alheir/gatebench/README.md

# GateBench

Educational FPGA lab board for the UPduino v3.1. Switches, LEDs, 7-segment display, VGA, R-2R DAC, ADC and WS2812 behind shift-register scan chains, with a Verilog BSP and worked examples.
