alheir/gatebench/hardware/3d/README.md

3D STEP models for the GateBench PCB (tracked with Git LFS).
