alheir/gatebench/(list of files, cad)

Other CAD files:
hardware/3d/EC11_Rotary_Encoder_Switched.step
hardware/3d/R-0904N-L-20KQ.step
hardware/3d/UPduino_v3.01.step
hardware/3d/USB_B_OST_USB-B1HSxx_Horizontal.step
