alheir/gatebench/hardware/gatebench.kicad_pcb

## KiCad design hardware/gatebench.kicad_pcb (2026-09-05)

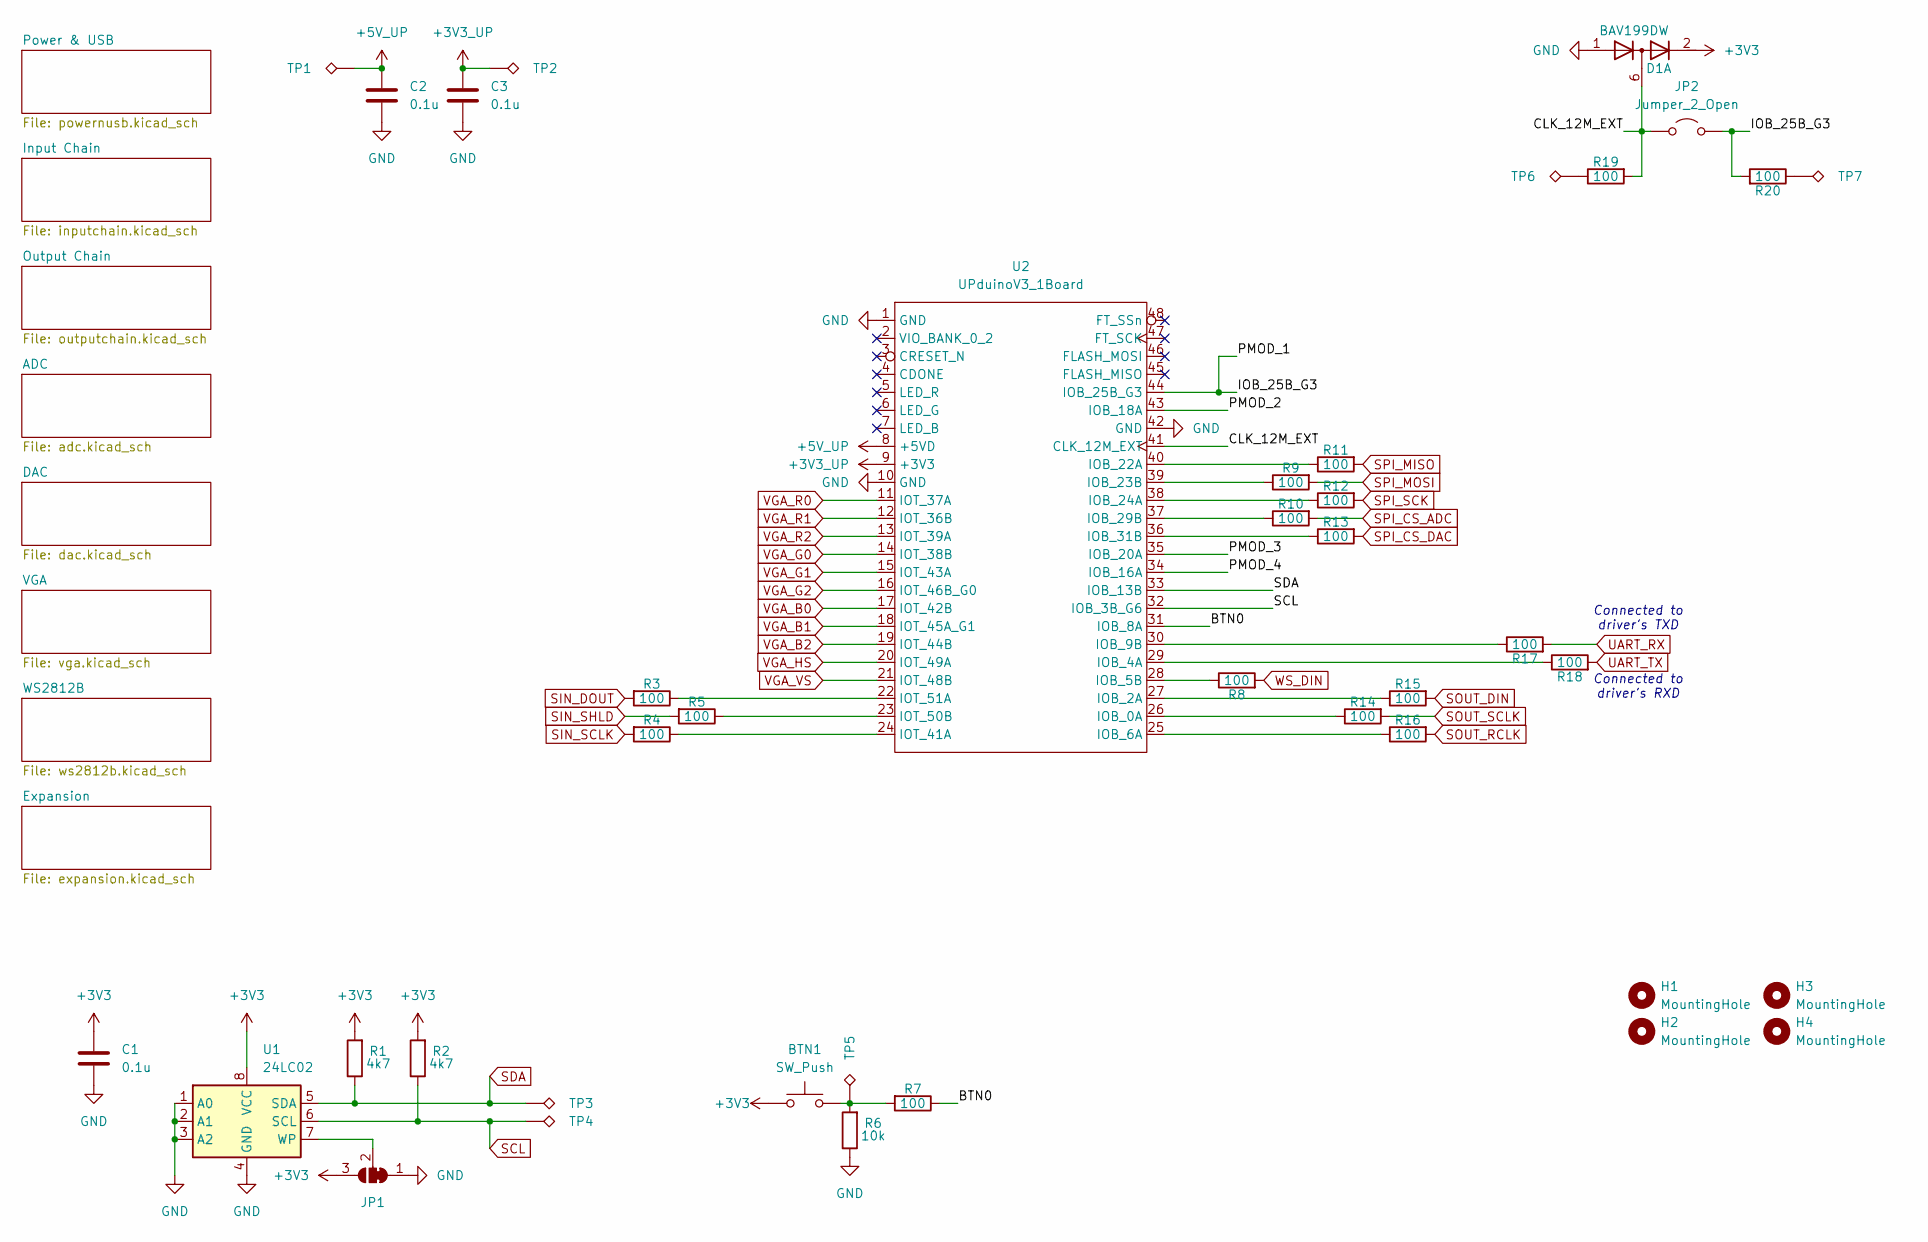
[picture p1: schematic gatebench.kicad_sch]

Parts:
BTN1: SW_Push; SW_PUSH_6mm_H8.5mm; JLCPCB C22397158
C1, C2, C3: 0.1u; C_0603_1608Metric_Pad1.08x0.95mm_HandSolder; JLCPCB C1705
D1: BAV199DW; SOT-363_SC-70-6
H1, H2, H3, H4: MountingHole; MountingHole_3.2mm_M3
JP1: SolderJumper_3_Bridged12; SolderJumper-3_P1.3mm_Bridged2Bar12_RoundedPad1.0x1.5mm_Num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
JP2: Jumper_2_Open
R1, R2: 4k7; R_0603_1608Metric; JLCPCB C22356621
R3, R4, R5, R7, R8, R9, R10, R11, R12, R13, R14, R15, R16, R17, R18, R19, R20: 100; R_0603_1608Metric; JLCPCB C22356621
R6: 10k; R_0603_1608Metric; JLCPCB C22356621
TP1, TP2, TP3, TP4, TP5, TP6, TP7: TestPoint_Alt; PinHeader_1x01_P2.54mm_Vertical
U1: 24LC02; SOIC-8_3.9x4.9mm_P1.27mm
U2: UPduinoV3_1Board; upduino_v3_1

Connections:
+3V3: BTN1.1, C1.1, D1.2 (K2), JP1.3 (B), R1.2, R2.2, U1.8 (VCC); also elsewhere on the board
+3V3_UP: C3.1, TP2.1 (1_1), U2.9 (+3V3); also elsewhere on the board
+5V_UP: C2.1, TP1.1 (1_1), U2.8 (+5VD); also elsewhere on the board
/BTN0: R7.1, U2.31 (IOB_8A)
/CLK_12M_EXT: D1.6 (K3A4), JP2.1 (A), R19.2, U2.41 (CLK_12M_EXT)
/IOB_25B_G3: JP2.2 (B), R20.2, U2.44 (IOB_25B_G3)
/PMOD_2: U2.43 (IOB_18A)
/PMOD_3: U2.35 (IOB_20A)
/PMOD_4: U2.34 (IOB_16A)
GND: C1.2, C2.2, C3.2, D1.1 (A1), JP1.1 (A), R6.1, U1.1 (A0), U1.2 (A1), U1.3 (A2), U1.4 (GND), U2.1 (GND), U2.10 (GND), U2.42 (GND); also elsewhere on the board
unnamed: BTN1.2, R6.2, R7.2, TP5.1 (1_1)
unnamed: JP1.2 (C), U1.7 (WP)
unnamed: R19.1, TP6.1 (1_1)
unnamed: R20.1, TP7.1 (1_1)
unnamed: R14.1, U2.26 (IOB_0A)
unnamed: R15.1, U2.27 (IOB_2A)
unnamed: R18.1, U2.29 (IOB_4A)
unnamed: R8.1, U2.28 (IOB_5B)
unnamed: R16.1, U2.25 (IOB_6A)
unnamed: R17.1, U2.30 (IOB_9B)
unnamed: R11.1, U2.40 (IOB_22A)
unnamed: R9.1, U2.39 (IOB_23B)
unnamed: R12.1, U2.38 (IOB_24A)
unnamed: R10.1, U2.37 (IOB_29B)
unnamed: R13.1, U2.36 (IOB_31B)
unnamed: R4.1, U2.24 (IOT_41A)
unnamed: R5.1, U2.23 (IOT_50B)
unnamed: R3.1, U2.22 (IOT_51A)
PMOD_7: R11.2; also elsewhere on the board
PMOD_8: R9.2; also elsewhere on the board
PMOD_9: R12.2; also elsewhere on the board
SCL: R2.1, TP4.1 (1_1), U1.6 (SCL), U2.32 (IOB_3B_G6); also elsewhere on the board
SDA: R1.1, TP3.1 (1_1), U1.5 (SDA), U2.33 (IOB_13B); also elsewhere on the board
SIN_DOUT: R3.2; also elsewhere on the board
SIN_SCLK: R4.2; also elsewhere on the board
SIN_SHLD: R5.2; also elsewhere on the board
SOUT_DIN: R15.2; also elsewhere on the board
SOUT_RCLK: R16.2; also elsewhere on the board
SOUT_SCLK: R14.2; also elsewhere on the board
SPI_CS_ADC: R10.2; also elsewhere on the board
SPI_CS_DAC: R13.2; also elsewhere on the board
UART_RX: R17.2; also elsewhere on the board
UART_TX: R18.2; also elsewhere on the board
VGA_B0: U2.17 (IOT_42B); also elsewhere on the board
VGA_B1: U2.18 (IOT_45A_G1); also elsewhere on the board
VGA_B2: U2.19 (IOT_44B); also elsewhere on the board
VGA_G0: U2.14 (IOT_38B); also elsewhere on the board
VGA_G1: U2.15 (IOT_43A); also elsewhere on the board
VGA_G2: U2.16 (IOT_46B_G0); also elsewhere on the board
VGA_HS: U2.20 (IOT_49A); also elsewhere on the board
VGA_R0: U2.11 (IOT_37A); also elsewhere on the board
VGA_R1: U2.12 (IOT_36B); also elsewhere on the board
VGA_R2: U2.13 (IOT_39A); also elsewhere on the board
VGA_VS: U2.21 (IOT_48B); also elsewhere on the board
WS_DIN: R8.2; also elsewhere on the board

Notes on the sheet:
Connected to driver's TXD
Connected to driver's RXD

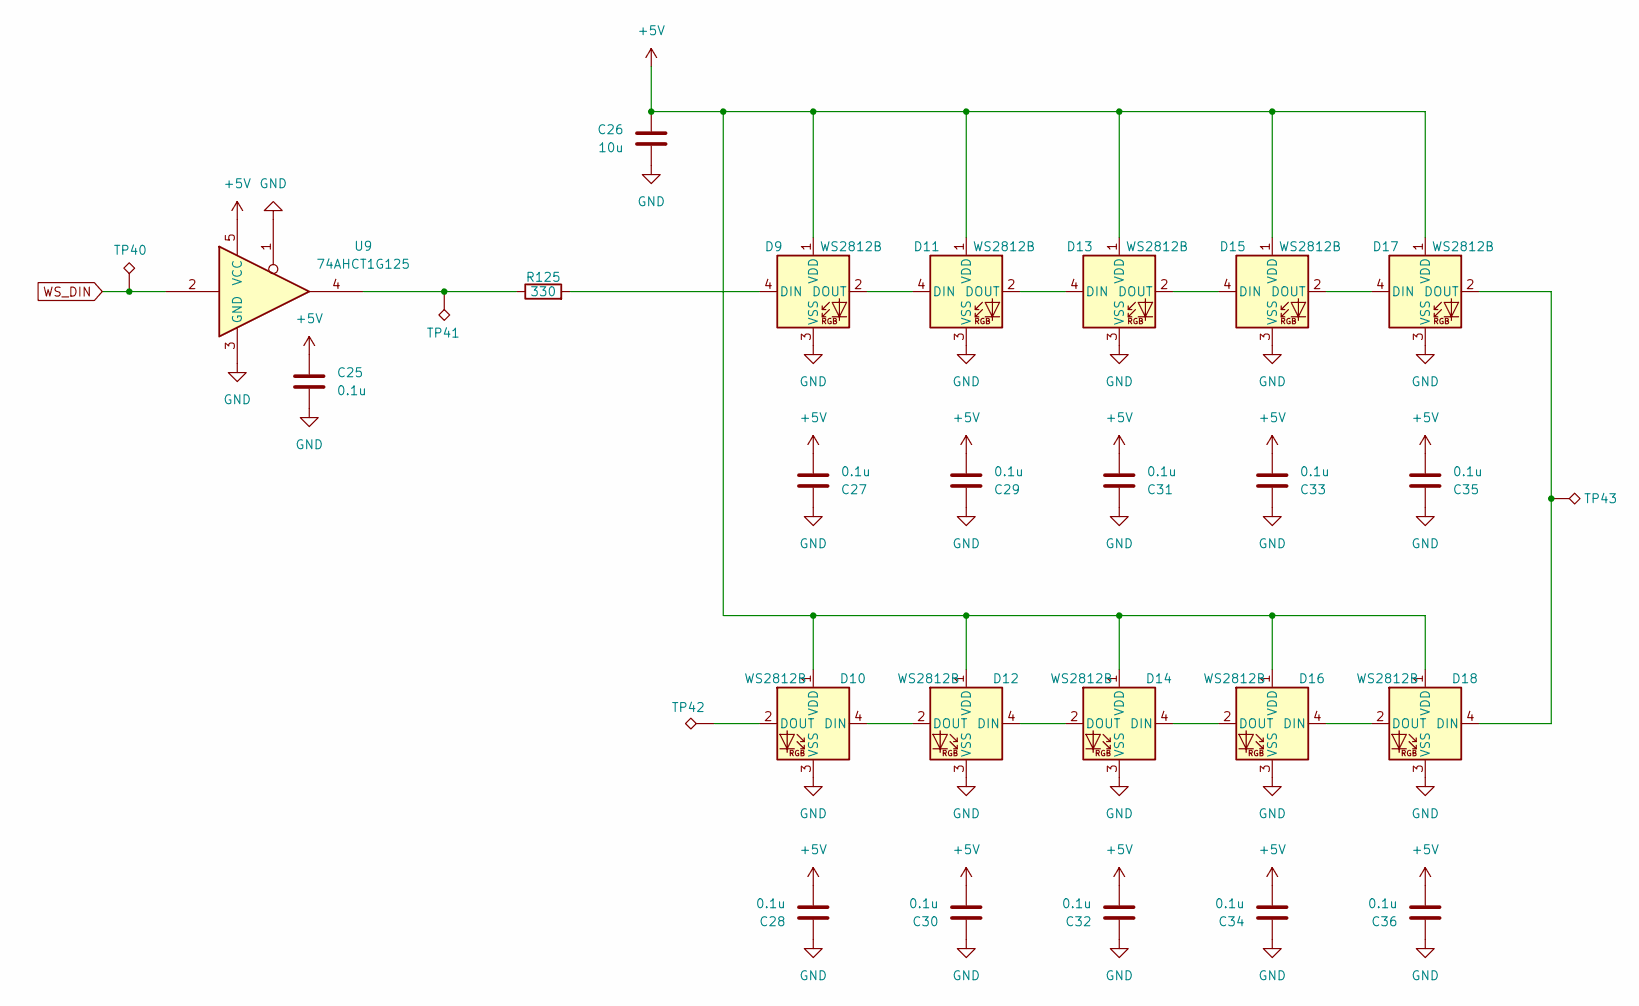
[picture p2: schematic ws2812b.kicad_sch]

Parts:
C25, C27, C28, C29, C30, C31, C32, C33, C34, C35, C36: 0.1u; C_0603_1608Metric_Pad1.08x0.95mm_HandSolder; JLCPCB C1705
C26: 10u; C_0603_1608Metric_Pad1.08x0.95mm_HandSolder; JLCPCB C1705
D9, D10, D11, D12, D13, D14, D15, D16, D17, D18: WS2812B; LED_WS2812B_PLCC4_5.0x5.0mm_P3.2mm; LCSC Part # C2843785
R125: 330; R_0603_1608Metric; JLCPCB C22356621
TP40, TP41, TP42, TP43: TestPoint_Alt; PinHeader_1x01_P2.54mm_Vertical
U9: 74AHCT1G125; SOT-23-5

Connections:
+5V: C25.1, C26.1, C27.2, C28.2, C29.2, C30.2, C31.2, C32.2, C33.2, C34.2, C35.2, C36.2, D9.1 (VDD), D10.1 (VDD), D11.1 (VDD), D12.1 (VDD), D13.1 (VDD), D14.1 (VDD), D15.1 (VDD), D16.1 (VDD), D17.1 (VDD), D18.1 (VDD), U9.5 (VCC); also elsewhere on the board
GND: C25.2, C26.2, C27.1, C28.1, C29.1, C30.1, C31.1, C32.1, C33.1, C34.1, C35.1, C36.1, D9.3 (VSS), D10.3 (VSS), D11.3 (VSS), D12.3 (VSS), D13.3 (VSS), D14.3 (VSS), D15.3 (VSS), D16.3 (VSS), D17.3 (VSS), D18.3 (VSS), U9.1, U9.3 (GND); also elsewhere on the board
unnamed: D9.4 (DIN), R125.2
unnamed: D10.4 (DIN), D12.2 (DOUT)
unnamed: D10.2 (DOUT), TP42.1 (1_1)
unnamed: D9.2 (DOUT), D11.4 (DIN)
unnamed: D11.2 (DOUT), D13.4 (DIN)
unnamed: D12.4 (DIN), D14.2 (DOUT)
unnamed: D13.2 (DOUT), D15.4 (DIN)
unnamed: D14.4 (DIN), D16.2 (DOUT)
unnamed: D15.2 (DOUT), D17.4 (DIN)
unnamed: D16.4 (DIN), D18.2 (DOUT)
unnamed: D17.2 (DOUT), D18.4 (DIN), TP43.1 (1_1)
unnamed: R125.1, TP41.1 (1_1), U9.4
WS_DIN: TP40.1 (1_1), U9.2; also elsewhere on the board

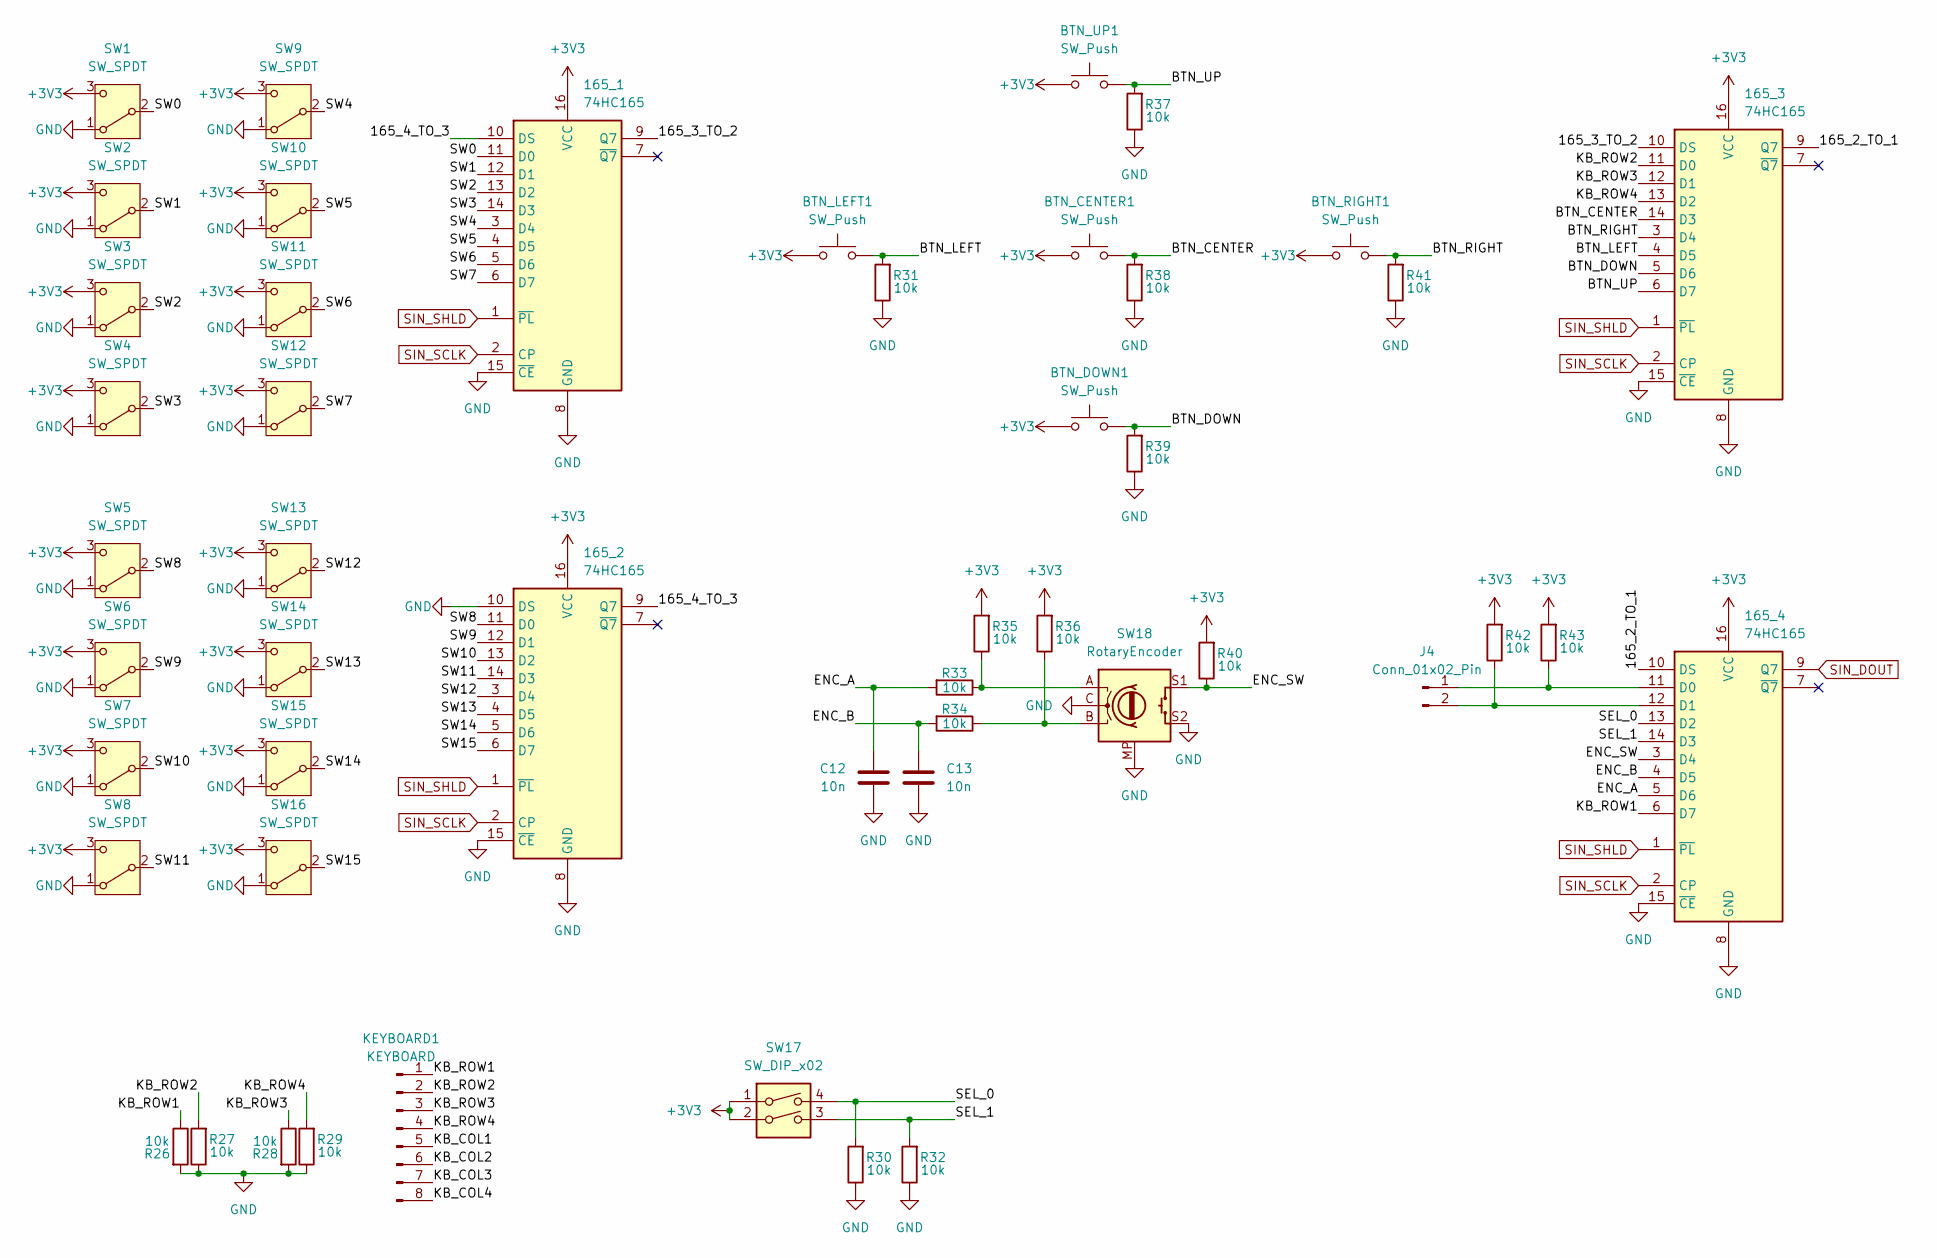
[picture p3: schematic inputchain.kicad_sch]

Parts:
165_1, 165_2, 165_3, 165_4: 74HC165; SO-16_3.9x9.9mm_P1.27mm
BTN_CENTER1: SW_Push; SW_PUSH_6mm_H8.5mm; JLCPCB C22397158
BTN_DOWN1: SW_Push; SW_PUSH_6mm_H8.5mm; JLCPCB C22397158
BTN_LEFT1: SW_Push; SW_PUSH_6mm_H8.5mm; JLCPCB C22397158
BTN_RIGHT1: SW_Push; SW_PUSH_6mm_H8.5mm; JLCPCB C22397158
BTN_UP1: SW_Push; SW_PUSH_6mm_H8.5mm; JLCPCB C22397158
C12, C13: 10n; C_0603_1608Metric_Pad1.08x0.95mm_HandSolder; JLCPCB C1705
J4: Conn_01x02_Pin; PinHeader_1x02_P2.54mm_Vertical
KEYBOARD1: KEYBOARD; PinHeader_1x08_P2.54mm_Horizontal
R26, R27, R28, R29, R30, R31, R32, R33, R34, R35, R36, R37, R38, R39, R40, R41, R42, R43: 10k; R_0603_1608Metric; JLCPCB C22356621
SW1, SW2, SW3, SW4, SW5, SW6, SW7, SW8, SW9, SW10, SW11, SW12, SW13, SW14, SW15, SW16: SW_SPDT; SW_Slide_SPDT_Straight_CK_OS102011MS2Q; JLCPCB C22435632
SW17: SW_DIP_x02; SW_DIP_SPSTx02_Slide_9.78x7.26mm_W7.62mm_P2.54mm; JLCPCB C5299503
SW18: RotaryEncoder; RotaryEncoder_Alps_EC11E-Switch_Vertical_H20mm

Connections:
+3V3: 165_1.16 (VCC), 165_2.16 (VCC), 165_3.16 (VCC), 165_4.16 (VCC), BTN_CENTER1.1, BTN_DOWN1.1, BTN_LEFT1.1, BTN_RIGHT1.1, BTN_UP1.1, R35.2, R36.2, R40.2, R42.2, R43.2, SW1.3 (C), SW2.3 (C), SW3.3 (C), SW4.3 (C), SW5.3 (C), SW6.3 (C), SW7.3 (C), SW8.3 (C), SW9.3 (C), SW10.3 (C), SW11.3 (C), SW12.3 (C), SW13.3 (C), SW14.3 (C), SW15.3 (C), SW16.3 (C), SW17.1, SW17.2; also elsewhere on the board
/Input Chain/165_2_TO_1: 165_3.9 (Q7), 165_4.10 (DS)
/Input Chain/165_3_TO_2: 165_1.9 (Q7), 165_3.10 (DS)
/Input Chain/165_4_TO_3: 165_1.10 (DS), 165_2.9 (Q7)
/Input Chain/BTN_CENTER: 165_3.14 (D3), BTN_CENTER1.2, R38.2
/Input Chain/BTN_DOWN: 165_3.5 (D6), BTN_DOWN1.2, R39.2
/Input Chain/BTN_LEFT: 165_3.4 (D5), BTN_LEFT1.2, R31.2
/Input Chain/BTN_RIGHT: 165_3.3 (D4), BTN_RIGHT1.2, R41.2
/Input Chain/BTN_UP: 165_3.6 (D7), BTN_UP1.2, R37.2
/Input Chain/ENC_A: 165_4.5 (D6), C12.1, R33.2
/Input Chain/ENC_B: 165_4.4 (D5), C13.1, R34.2
/Input Chain/ENC_SW: 165_4.3 (D4), R40.1, SW18.S1
/Input Chain/KB_COL1: KEYBOARD1.5
/Input Chain/KB_COL2: KEYBOARD1.6
/Input Chain/KB_COL3: KEYBOARD1.7
/Input Chain/KB_COL4: KEYBOARD1.8
/Input Chain/KB_ROW1: 165_4.6 (D7), KEYBOARD1.1, R26.1
/Input Chain/KB_ROW2: 165_3.11 (D0), KEYBOARD1.2, R27.2
/Input Chain/KB_ROW3: 165_3.12 (D1), KEYBOARD1.3, R28.1
/Input Chain/KB_ROW4: 165_3.13 (D2), KEYBOARD1.4, R29.2
/Input Chain/SEL_0: 165_4.13 (D2), R30.2, SW17.4
/Input Chain/SEL_1: 165_4.14 (D3), R32.2, SW17.3
/Input Chain/SW0: 165_1.11 (D0), SW1.2 (B)
/Input Chain/SW1: 165_1.12 (D1), SW2.2 (B)
/Input Chain/SW2: 165_1.13 (D2), SW3.2 (B)
/Input Chain/SW3: 165_1.14 (D3), SW4.2 (B)
/Input Chain/SW4: 165_1.3 (D4), SW9.2 (B)
/Input Chain/SW5: 165_1.4 (D5), SW10.2 (B)
/Input Chain/SW6: 165_1.5 (D6), SW11.2 (B)
/Input Chain/SW7: 165_1.6 (D7), SW12.2 (B)
/Input Chain/SW8: 165_2.11 (D0), SW5.2 (B)
/Input Chain/SW9: 165_2.12 (D1), SW6.2 (B)
/Input Chain/SW10: 165_2.13 (D2), SW7.2 (B)
/Input Chain/SW11: 165_2.14 (D3), SW8.2 (B)
/Input Chain/SW12: 165_2.3 (D4), SW13.2 (B)
/Input Chain/SW13: 165_2.4 (D5), SW14.2 (B)
/Input Chain/SW14: 165_2.5 (D6), SW15.2 (B)
/Input Chain/SW15: 165_2.6 (D7), SW16.2 (B)
GND: 165_1.8 (GND), 165_1.15 (~CE), 165_2.8 (GND), 165_2.10 (DS), 165_2.15 (~CE), 165_3.8 (GND), 165_3.15 (~CE), 165_4.8 (GND), 165_4.15 (~CE), C12.2, C13.2, R26.2, R27.1, R28.2, R29.1, R30.1, R31.1, R32.1, R37.1, R38.1, R39.1, R41.1, SW1.1 (A), SW2.1 (A), SW3.1 (A), SW4.1 (A), SW5.1 (A), SW6.1 (A), SW7.1 (A), SW8.1 (A), SW9.1 (A), SW10.1 (A), SW11.1 (A), SW12.1 (A), SW13.1 (A), SW14.1 (A), SW15.1 (A), SW16.1 (A), SW18.C, SW18.MP, SW18.S2; also elsewhere on the board
unnamed: 165_4.11 (D0), J4.1, R43.1
unnamed: 165_4.12 (D1), J4.2, R42.1
unnamed: R33.1, R35.1, SW18.A
unnamed: R34.1, R36.1, SW18.B
SIN_DOUT: 165_4.9 (Q7); also elsewhere on the board
SIN_SCLK: 165_1.2 (CP), 165_2.2 (CP), 165_3.2 (CP), 165_4.2 (CP); also elsewhere on the board
SIN_SHLD: 165_1.1 (~PL), 165_2.1 (~PL), 165_3.1 (~PL), 165_4.1 (~PL); also elsewhere on the board

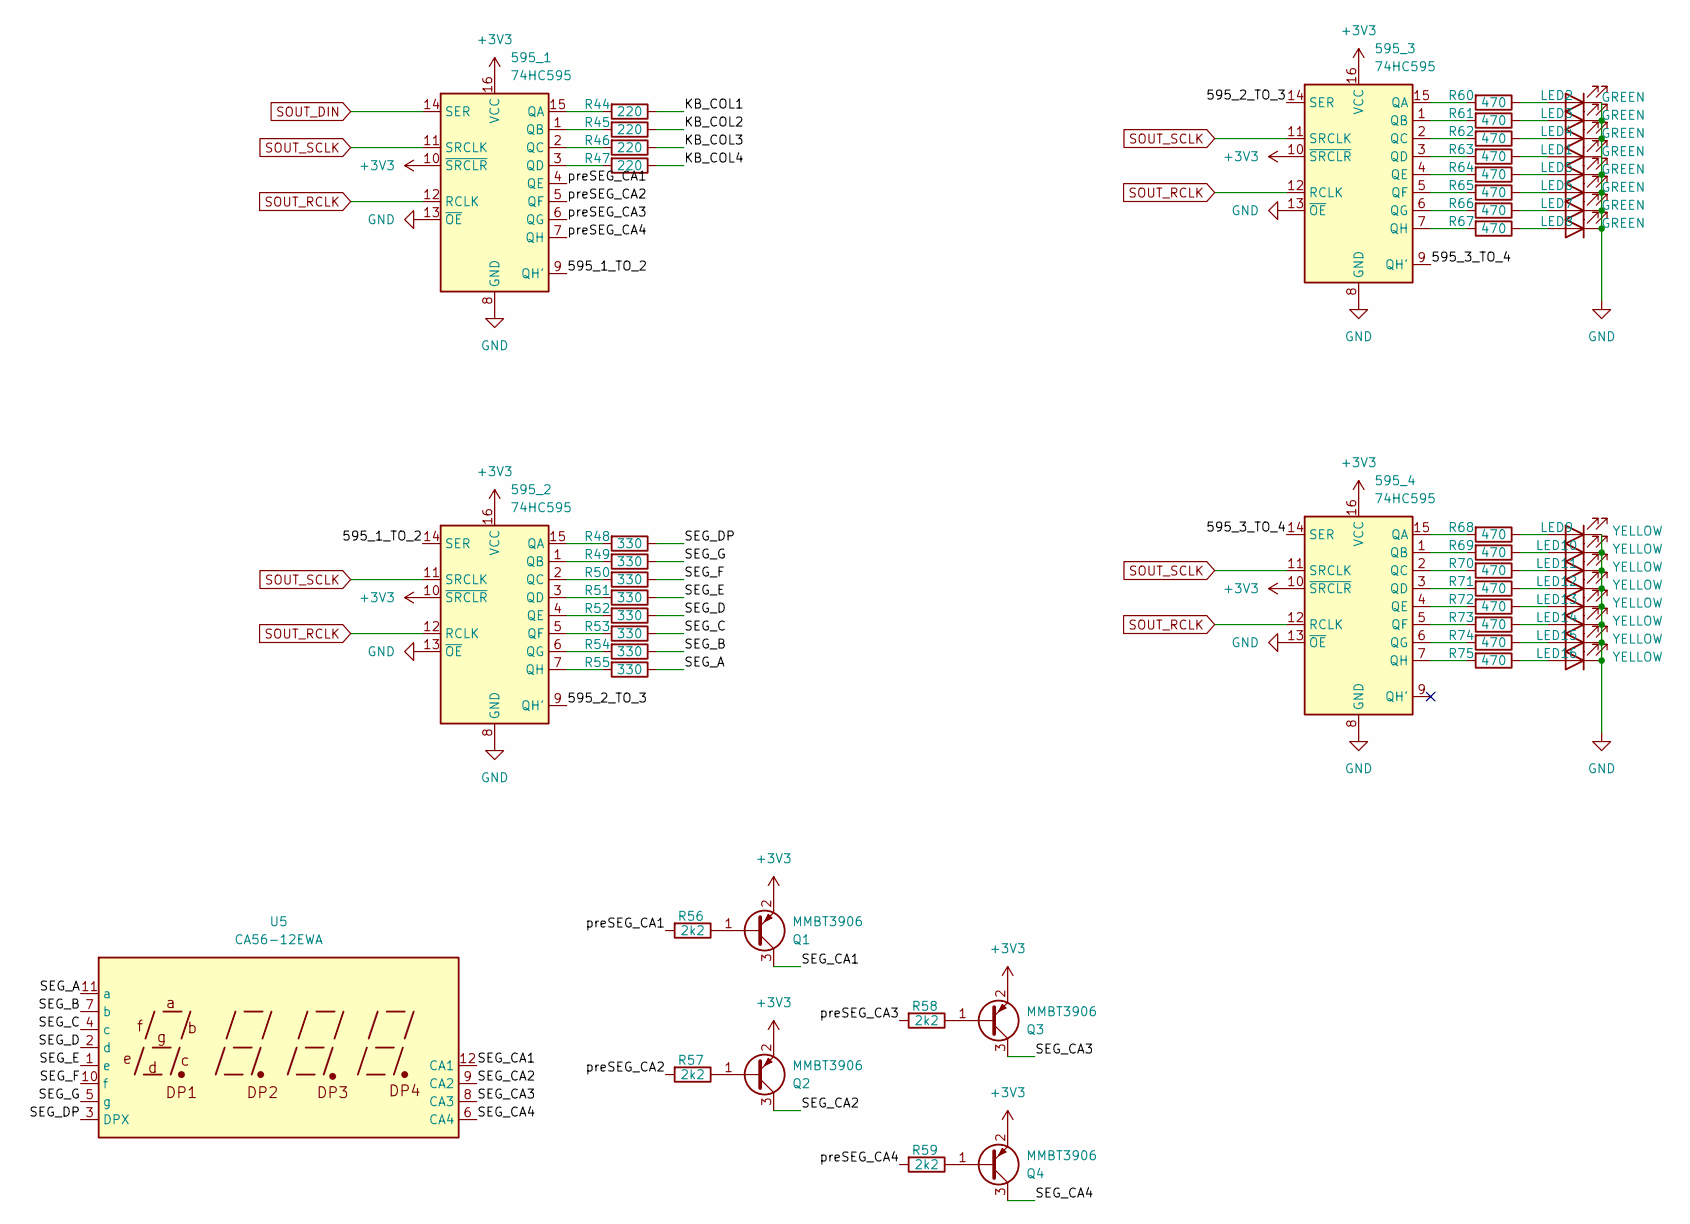
[picture p4: schematic outputchain.kicad_sch]

Parts:
595_1, 595_2, 595_3, 595_4: 74HC595; SOIC-16_3.9x9.9mm_P1.27mm
LED1, LED2, LED3, LED4, LED5, LED6, LED7, LED8: GREEN; LED_0603_1608Metric; LCSC Part # C12624
LED9, LED10, LED11, LED12, LED13, LED14, LED15, LED16: YELLOW; LED_0603_1608Metric; LCSC Part # C2287
Q1, Q2, Q3, Q4: MMBT3906; Nidec_Copal_CAS-120A
R44, R45, R46, R47: 220; R_0603_1608Metric; JLCPCB C22356621
R48, R49, R50, R51, R52, R53, R54, R55: 330; R_0603_1608Metric; JLCPCB C22356621
R56, R57, R58, R59: 2k2; R_0603_1608Metric; JLCPCB C22356621
R60, R61, R62, R63, R64, R65, R66, R67, R68, R69, R70, R71, R72, R73, R74, R75: 470; R_0603_1608Metric; JLCPCB C22356621
U5: CA56-12EWA

Connections:
+3V3: 595_1.10 (~SRCLR), 595_1.16 (VCC), 595_2.10 (~SRCLR), 595_2.16 (VCC), 595_3.10 (~SRCLR), 595_3.16 (VCC), 595_4.10 (~SRCLR), 595_4.16 (VCC), Q1.2 (E), Q2.2 (E), Q3.2 (E), Q4.2 (E); also elsewhere on the board
/Output Chain/595_1_TO_2: 595_1.9 (QH'), 595_2.14 (SER)
/Output Chain/595_2_TO_3: 595_2.9 (QH'), 595_3.14 (SER)
/Output Chain/595_3_TO_4: 595_3.9 (QH'), 595_4.14 (SER)
/Output Chain/KB_COL1: R44.1
/Output Chain/KB_COL2: R45.1
/Output Chain/KB_COL3: R46.1
/Output Chain/KB_COL4: R47.1
/Output Chain/SEG_A: R55.1, U5.11 (a)
/Output Chain/SEG_B: R54.1, U5.7 (b)
/Output Chain/SEG_C: R53.1, U5.4 (c)
/Output Chain/SEG_CA1: Q1.3 (C), U5.12 (CA1)
/Output Chain/SEG_CA2: Q2.3 (C), U5.9 (CA2)
/Output Chain/SEG_CA3: Q3.3 (C), U5.8 (CA3)
/Output Chain/SEG_CA4: Q4.3 (C), U5.6 (CA4)
/Output Chain/SEG_D: R52.1, U5.2 (d)
/Output Chain/SEG_DP: R48.1, U5.3 (DPX)
/Output Chain/SEG_E: R51.1, U5.1 (e)
/Output Chain/SEG_F: R50.1, U5.10 (f)
/Output Chain/SEG_G: R49.1, U5.5 (g)
/Output Chain/preSEG_CA1: 595_1.4 (QE), R56.2
/Output Chain/preSEG_CA2: 595_1.5 (QF), R57.2
/Output Chain/preSEG_CA3: 595_1.6 (QG), R58.2
/Output Chain/preSEG_CA4: 595_1.7 (QH), R59.2
GND: 595_1.8 (GND), 595_1.13 (~OE), 595_2.8 (GND), 595_2.13 (~OE), 595_3.8 (GND), 595_3.13 (~OE), 595_4.8 (GND), 595_4.13 (~OE), LED2.1 (K), LED3.1 (K), LED4.1 (K), LED5.1 (K), LED6.1 (K), LED7.1 (K), LED8.1 (K), LED9.1 (K), LED10.1 (K), LED11.1 (K), LED12.1 (K), LED13.1 (K), LED14.1 (K), LED15.1 (K), LED16.1 (K); also elsewhere on the board
unnamed: 595_1.15 (QA), R44.2
unnamed: 595_1.1 (QB), R45.2
unnamed: 595_1.2 (QC), R46.2
unnamed: 595_1.3 (QD), R47.2
unnamed: 595_2.15 (QA), R48.2
unnamed: 595_2.1 (QB), R49.2
unnamed: 595_2.2 (QC), R50.2
unnamed: 595_2.3 (QD), R51.2
unnamed: 595_2.4 (QE), R52.2
unnamed: 595_2.5 (QF), R53.2
unnamed: 595_2.6 (QG), R54.2
unnamed: 595_2.7 (QH), R55.2
unnamed: 595_3.15 (QA), R60.2
unnamed: 595_3.1 (QB), R61.2
unnamed: 595_3.2 (QC), R62.2
unnamed: 595_3.3 (QD), R63.2
unnamed: 595_3.4 (QE), R64.2
unnamed: 595_3.5 (QF), R65.2
unnamed: 595_3.6 (QG), R66.2
unnamed: 595_3.7 (QH), R67.2
unnamed: 595_4.15 (QA), R68.2
unnamed: 595_4.1 (QB), R69.2
unnamed: 595_4.2 (QC), R70.2
unnamed: 595_4.3 (QD), R71.2
unnamed: 595_4.4 (QE), R72.2
unnamed: 595_4.5 (QF), R73.2
unnamed: 595_4.6 (QG), R74.2
unnamed: 595_4.7 (QH), R75.2
unnamed: LED2.2 (A), R60.1
unnamed: LED3.2 (A), R61.1
unnamed: LED4.2 (A), R62.1
unnamed: LED5.2 (A), R64.1
unnamed: LED6.2 (A), R65.1
unnamed: LED7.2 (A), R66.1
unnamed: LED8.2 (A), R67.1
unnamed: LED9.2 (A), R68.1
unnamed: LED10.2 (A), R69.1
unnamed: LED11.2 (A), R70.1
unnamed: LED12.2 (A), R71.1
unnamed: LED13.2 (A), R72.1
unnamed: LED14.2 (A), R73.1
unnamed: LED15.2 (A), R74.1
unnamed: LED16.2 (A), R75.1
unnamed: Q1.1 (B), R56.1
unnamed: Q2.1 (B), R57.1
unnamed: Q3.1 (B), R58.1
unnamed: Q4.1 (B), R59.1
SOUT_DIN: 595_1.14 (SER); also elsewhere on the board
SOUT_RCLK: 595_1.12 (RCLK), 595_2.12 (RCLK), 595_3.12 (RCLK), 595_4.12 (RCLK); also elsewhere on the board
SOUT_SCLK: 595_1.11 (SRCLK), 595_2.11 (SRCLK), 595_3.11 (SRCLK), 595_4.11 (SRCLK); also elsewhere on the board

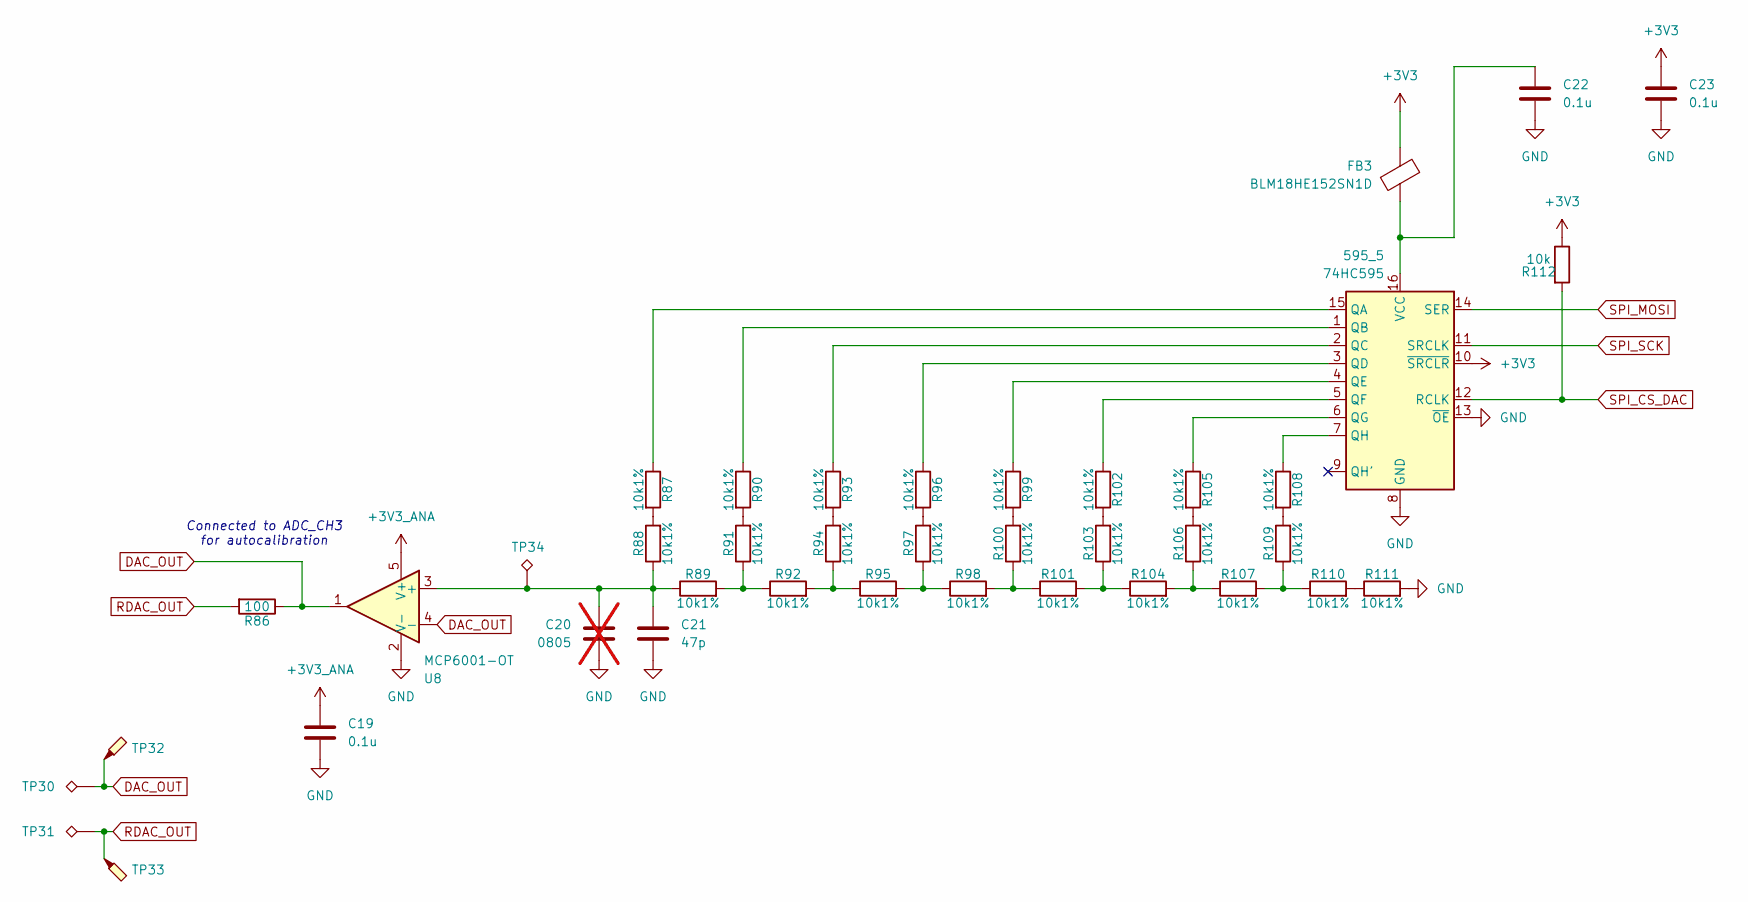
[picture p5: schematic dac.kicad_sch]

Parts:
595_5: 74HC595; SOIC-16_3.9x9.9mm_P1.27mm
C19, C22, C23: 0.1u; C_0603_1608Metric_Pad1.08x0.95mm_HandSolder; JLCPCB C1705
C20: 0805; C_0603_1608Metric_Pad1.08x0.95mm_HandSolder; JLCPCB C1705; not fitted
C21: 47p; C_0603_1608Metric_Pad1.08x0.95mm_HandSolder; JLCPCB C1705
FB3: BLM18HE152SN1D; L_0603_1608Metric; LCSC Part # C82155
R86: 100; R_0603_1608Metric; JLCPCB C22356621
R87, R88, R89, R90, R91, R92, R93, R94, R95, R96, R97, R98, R99, R100, R101, R102, R103, R104, R105, R106, R107, R108, R109, R110, R111: 10k1%; R_0603_1608Metric; JLCPCB C22356621
R112: 10k; R_0603_1608Metric; JLCPCB C22356621
TP30, TP31, TP34: TestPoint_Alt; PinHeader_1x01_P2.54mm_Vertical
TP32, TP33: TestPoint_Probe; TestPoint_Loop_D2.60mm_Drill0.9mm_Beaded
U8: MCP6001-OT; SOT-23-5

Connections:
+3V3: 595_5.10 (~SRCLR), C23.1, FB3.2, R112.1; also elsewhere on the board
+3V3_ANA: C19.1, U8.5 (V+); also elsewhere on the board
DAC_OUT: R86.1, TP30.1 (1_1), TP32.1 (1_1), U8.1, U8.4 (-); also elsewhere on the board
GND: 595_5.8 (GND), 595_5.13 (~OE), C19.2, C20.2, C21.2, C22.2, C23.2, R111.2, U8.2 (V-); also elsewhere on the board
unnamed: 595_5.15 (QA), R87.1
unnamed: 595_5.1 (QB), R90.1
unnamed: 595_5.2 (QC), R93.1
unnamed: 595_5.3 (QD), R96.1
unnamed: 595_5.4 (QE), R99.1
unnamed: 595_5.5 (QF), R102.1
unnamed: 595_5.6 (QG), R105.1
unnamed: 595_5.7 (QH), R108.1
unnamed: 595_5.16 (VCC), C22.1, FB3.1
unnamed: R87.2, R88.2
unnamed: R89.2, R91.1, R92.1
unnamed: R90.2, R91.2
unnamed: R92.2, R94.1, R95.1
unnamed: R93.2, R94.2
unnamed: R95.2, R97.1, R98.1
unnamed: R96.2, R97.2
unnamed: R98.2, R100.1, R101.1
unnamed: R99.2, R100.2
unnamed: R101.2, R103.1, R104.1
unnamed: R102.2, R103.2
unnamed: R104.2, R106.1, R107.1
unnamed: R105.2, R106.2
unnamed: R107.2, R109.1, R110.1
unnamed: R108.2, R109.2
unnamed: R110.2, R111.1
unnamed: C20.1, C21.1, R88.1, R89.1, TP34.1 (1_1), U8.3 (+)
PMOD_8: 595_5.14 (SER); also elsewhere on the board
PMOD_9: 595_5.11 (SRCLK); also elsewhere on the board
RDAC_OUT: R86.2, TP31.1 (1_1), TP33.1 (1_1)
SPI_CS_DAC: 595_5.12 (RCLK), R112.2; also elsewhere on the board

Notes on the sheet:
Connected to ADC_CH3 for autocalibration

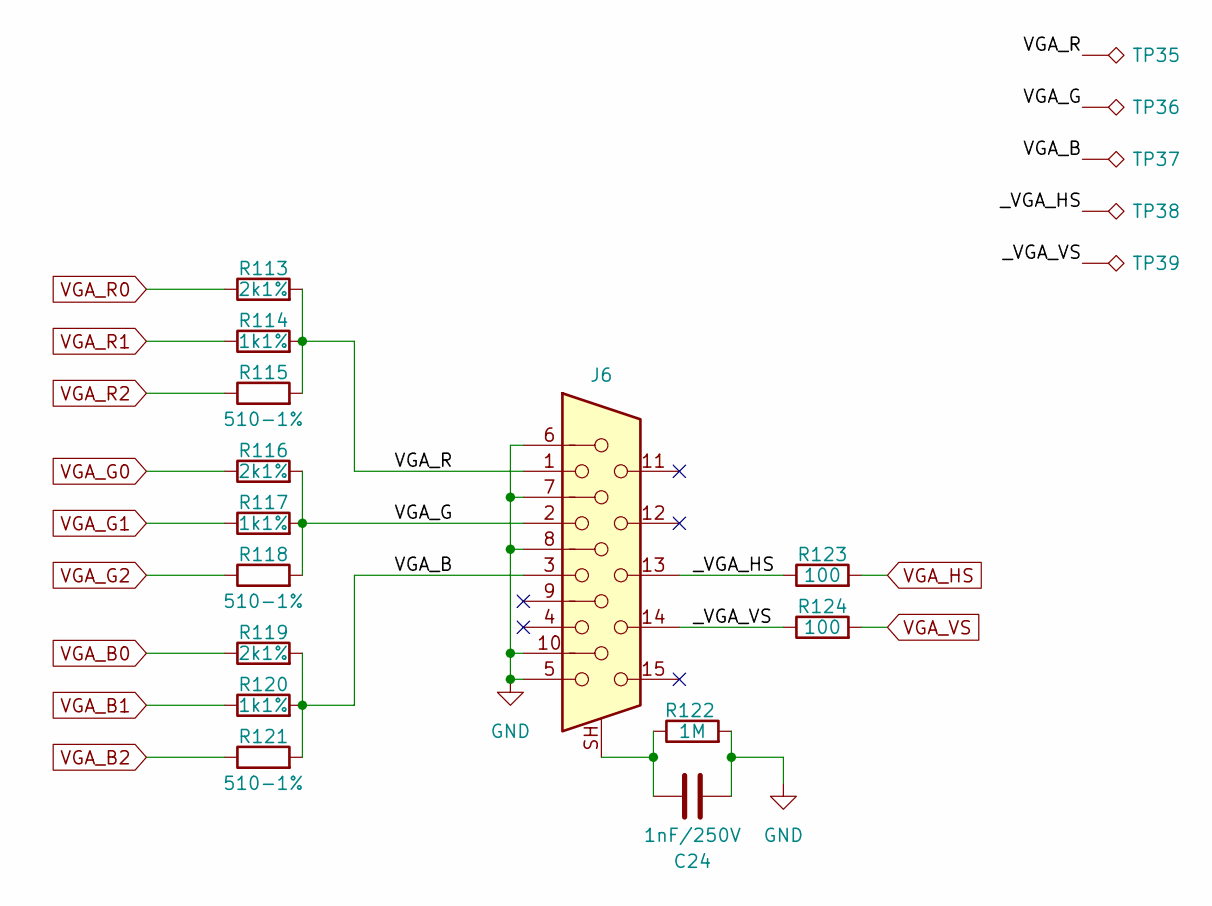
[picture p6: schematic vga.kicad_sch]

Parts:
C24: 1nF/250V; C_0603_1608Metric_Pad1.08x0.95mm_HandSolder; JLCPCB C277510
J6: DE15_Socket_HighDensity_MountingHoles; DSUB-15-HD_Socket_Horizontal_P2.29x2.54mm_EdgePinOffset8.35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; LCSC Part # C138387
R113, R116, R119: 2k1%; R_0603_1608Metric; JLCPCB C22356621
R114, R117, R120: 1k1%; R_0603_1608Metric; JLCPCB C22356621
R115, R118, R121: 510-1%; R_0603_1608Metric; JLCPCB C22356621
R122: 1M; R_0603_1608Metric; JLCPCB C22356623
R123, R124: 100; R_0603_1608Metric; JLCPCB C22356621
TP35, TP36, TP37, TP38, TP39: TestPoint_Alt; PinHeader_1x01_P2.54mm_Vertical

Connections:
/VGA/VGA_B: J6.3, R119.2, R120.2, R121.2, TP37.1 (1_1)
/VGA/VGA_G: J6.2, R116.2, R117.2, R118.2, TP36.1 (1_1)
/VGA/VGA_R: J6.1, R113.2, R114.2, R115.2, TP35.1 (1_1)
/VGA/_VGA_HS: J6.13, R123.1, TP38.1 (1_1)
/VGA/_VGA_VS: J6.14, R124.1, TP39.1 (1_1)
GND: C24.1, J6.5, J6.6, J6.7, J6.8, J6.10, R122.2; also elsewhere on the board
unnamed: C24.2, J6.SH, R122.1
VGA_B0: R119.1; also elsewhere on the board
VGA_B1: R120.1; also elsewhere on the board
VGA_B2: R121.1; also elsewhere on the board
VGA_G0: R116.1; also elsewhere on the board
VGA_G1: R117.1; also elsewhere on the board
VGA_G2: R118.1; also elsewhere on the board
VGA_HS: R123.2; also elsewhere on the board
VGA_R0: R113.1; also elsewhere on the board
VGA_R1: R114.1; also elsewhere on the board
VGA_R2: R115.1; also elsewhere on the board
VGA_VS: R124.2; also elsewhere on the board
