alheir/gatebench/hardware/gatebench.kicad_pcb

## KiCad design hardware/gatebench.kicad_pcb (continued)

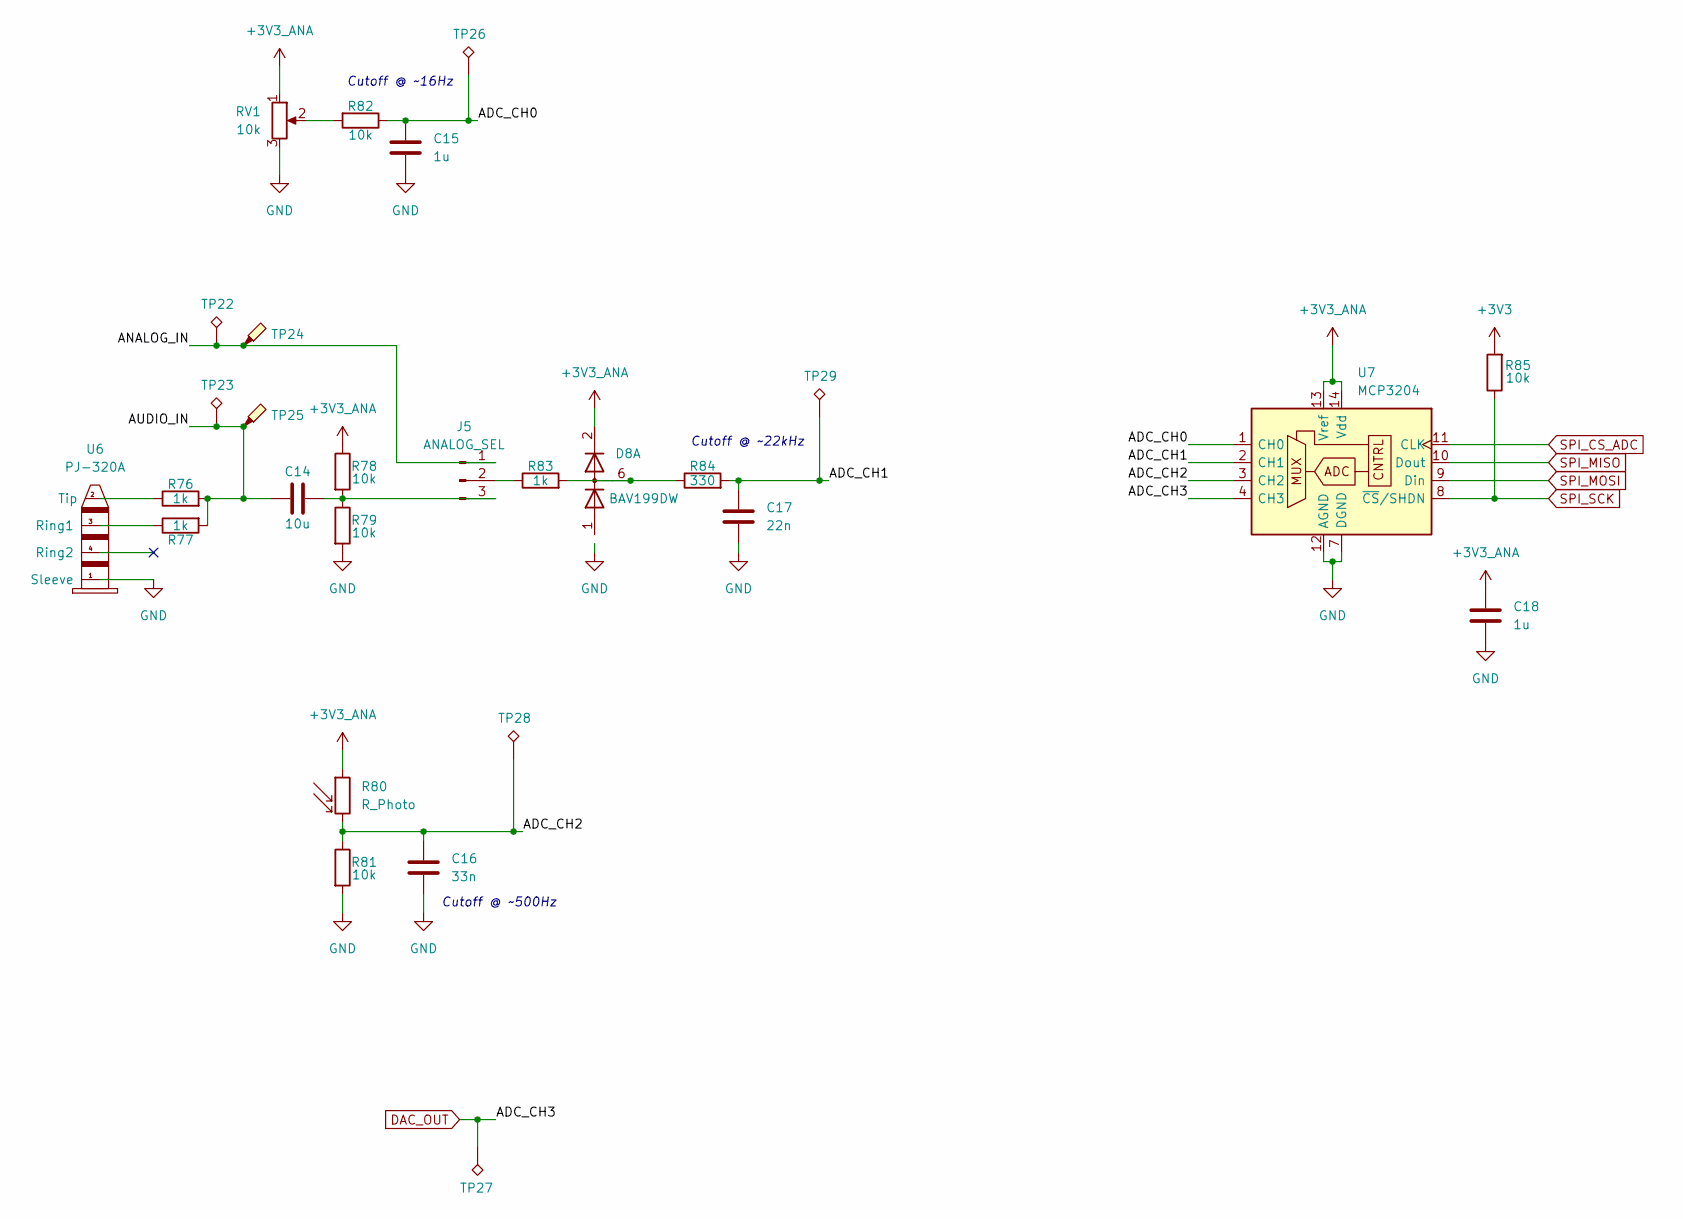
[picture p7: schematic adc.kicad_sch]

Parts:
C14: 10u; C_0603_1608Metric_Pad1.08x0.95mm_HandSolder; JLCPCB C1705
C15, C18: 1u; C_0603_1608Metric_Pad1.08x0.95mm_HandSolder; JLCPCB C1705
C16: 33n; C_0603_1608Metric_Pad1.08x0.95mm_HandSolder; JLCPCB C1705
C17: 22n; C_0603_1608Metric_Pad1.08x0.95mm_HandSolder; JLCPCB C1705
D8: BAV199DW; SOT-363_SC-70-6
J5: ANALOG_SEL; PinHeader_1x03_P2.54mm_Vertical
R76, R77, R83: 1k; R_0603_1608Metric; JLCPCB C22356621
R78, R79, R81, R82, R85: 10k; R_0603_1608Metric; JLCPCB C22356621
R80: R_Photo; R_LDR_7x6mm_P5.1mm_Vertical
R84: 330; R_0603_1608Metric; JLCPCB C22356621
RV1: 10k; Potentiometer_Alps_RK09K_Single_Vertical; LCSC Part # C470307
TP22, TP23, TP26, TP27, TP28, TP29: TestPoint_Alt; PinHeader_1x01_P2.54mm_Vertical
TP24, TP25: TestPoint_Probe; TestPoint_Loop_D2.60mm_Drill0.9mm_Beaded
U6: PJ-320A; LCSC Part # C18185602
U7: MCP3204; SOIC-14_3.9x8.7mm_P1.27mm

Connections:
+3V3: R85.2; also elsewhere on the board
+3V3_ANA: C18.1, D8.2 (K2), R78.1, R80.1, RV1.1, U7.13 (Vref), U7.14 (Vdd); also elsewhere on the board
/ADC/ADC_CH0: C15.1, R82.1, TP26.1 (1_1), U7.1 (CH0)
/ADC/ADC_CH1: C17.1, R84.2, TP29.1 (1_1), U7.2 (CH1)
/ADC/ADC_CH2: C16.1, R80.2, R81.1, TP28.1 (1_1), U7.3 (CH2)
/ADC/ANALOG_IN: J5.1, TP22.1 (1_1), TP24.1 (1_1)
/ADC/AUDIO_IN: C14.2, R76.2, R77.2, TP23.1 (1_1), TP25.1 (1_1)
DAC_OUT: TP27.1 (1_1), U7.4 (CH3); also elsewhere on the board
GND: C15.2, C16.2, C17.2, C18.2, R79.2, R81.2, RV1.3, U6.1 (Sleeve), U7.7 (DGND), U7.12 (AGND); also elsewhere on the board
unnamed: D8.6 (K3A4), R83.2, R84.1
unnamed: J5.2, R83.1
unnamed: C14.1, J5.3, R78.2, R79.1
unnamed: R82.2, RV1.2
unnamed: R77.1, U6.3 (Ring1)
unnamed: R76.1, U6.2 (Tip)
PMOD_7: U7.10 (Dout); also elsewhere on the board
PMOD_8: U7.9 (Din); also elsewhere on the board
PMOD_9: R85.1, U7.8 (~CS/SHDN); also elsewhere on the board
SPI_CS_ADC: U7.11 (CLK); also elsewhere on the board

Notes on the sheet:
Cutoff @ ~22kHz
Cutoff @ ~500Hz
Cutoff @ ~16Hz

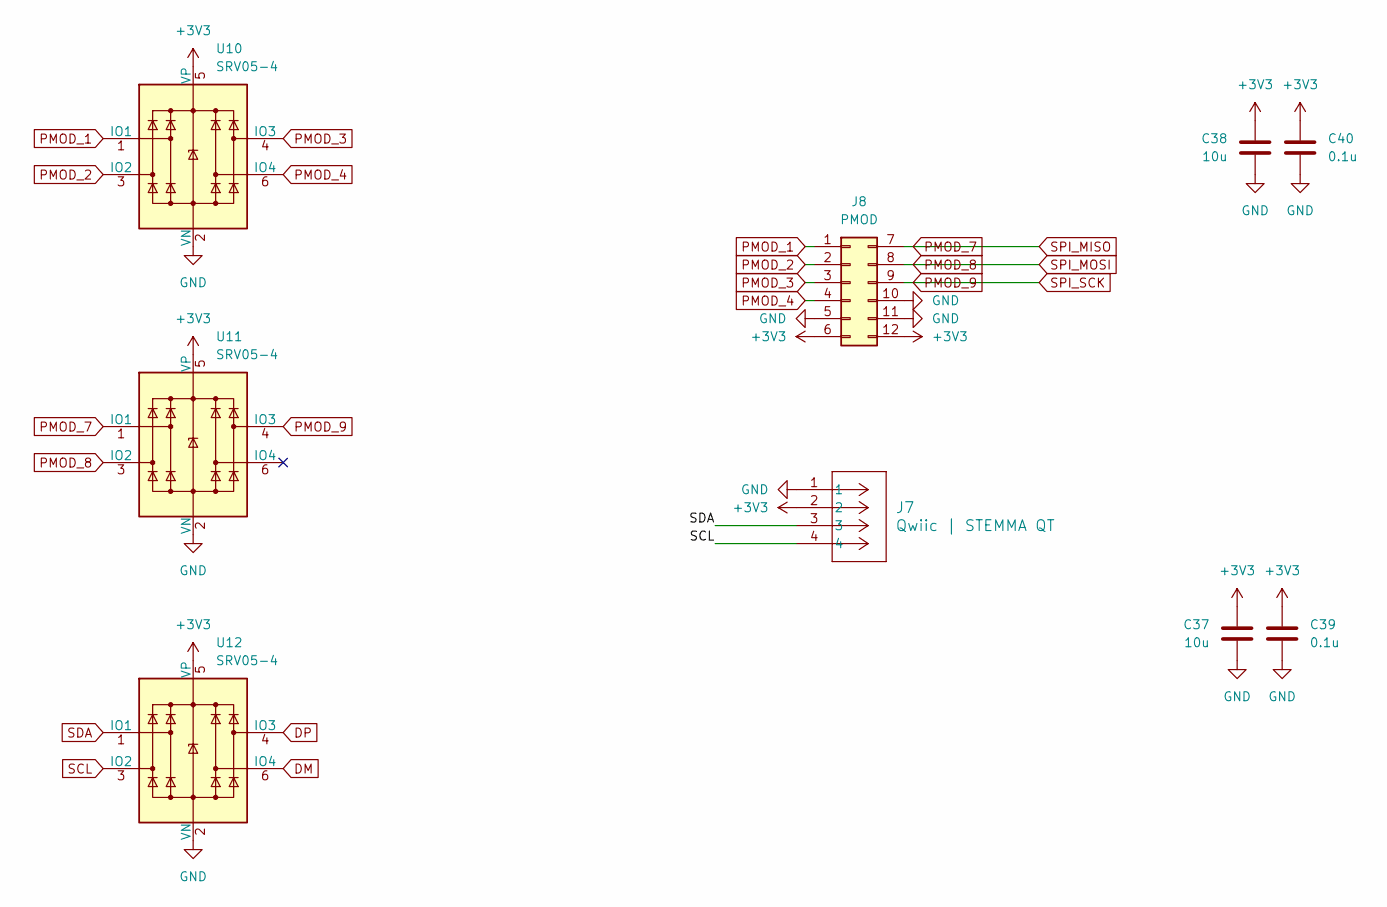
[picture p8: schematic expansion.kicad_sch]

Parts:
C37, C38: 10u; C_0603_1608Metric_Pad1.08x0.95mm_HandSolder; JLCPCB C1705
C39, C40: 0.1u; C_0603_1608Metric_Pad1.08x0.95mm_HandSolder; JLCPCB C1705
J7: Qwiic | STEMMA QT; CONN_SM04B_JST; LCSC Part # C51940130
J8: PMOD; PinHeader_2x06_P2.54mm_Horizontal
U10, U11, U12: SRV05-4; SOT-23-5; LCSC Part # C558418

Connections:
+3V3: C37.1, C38.1, C39.1, C40.1, J7.2, J8.6, J8.12, U10.5 (VP), U11.5 (VP), U12.5 (VP); also elsewhere on the board
DP: U12.4 (IO3); also elsewhere on the board
GND: C37.2, C38.2, C39.2, C40.2, J7.1, J8.5, J8.10, J8.11, U10.2 (VN), U11.2 (VN), U12.2 (VN); also elsewhere on the board
PMOD_1: J8.1, U10.1 (IO1)
PMOD_2: J8.2, U10.3 (IO2)
PMOD_3: J8.3, U10.4 (IO3)
PMOD_4: J8.4, U10.6 (IO4)
PMOD_7: J8.7, U11.1 (IO1); also elsewhere on the board
PMOD_8: J8.8, U11.3 (IO2); also elsewhere on the board
PMOD_9: J8.9, U11.4 (IO3); also elsewhere on the board
SCL: J7.4, U12.3 (IO2); also elsewhere on the board
SDA: J7.3, U12.1 (IO1); also elsewhere on the board

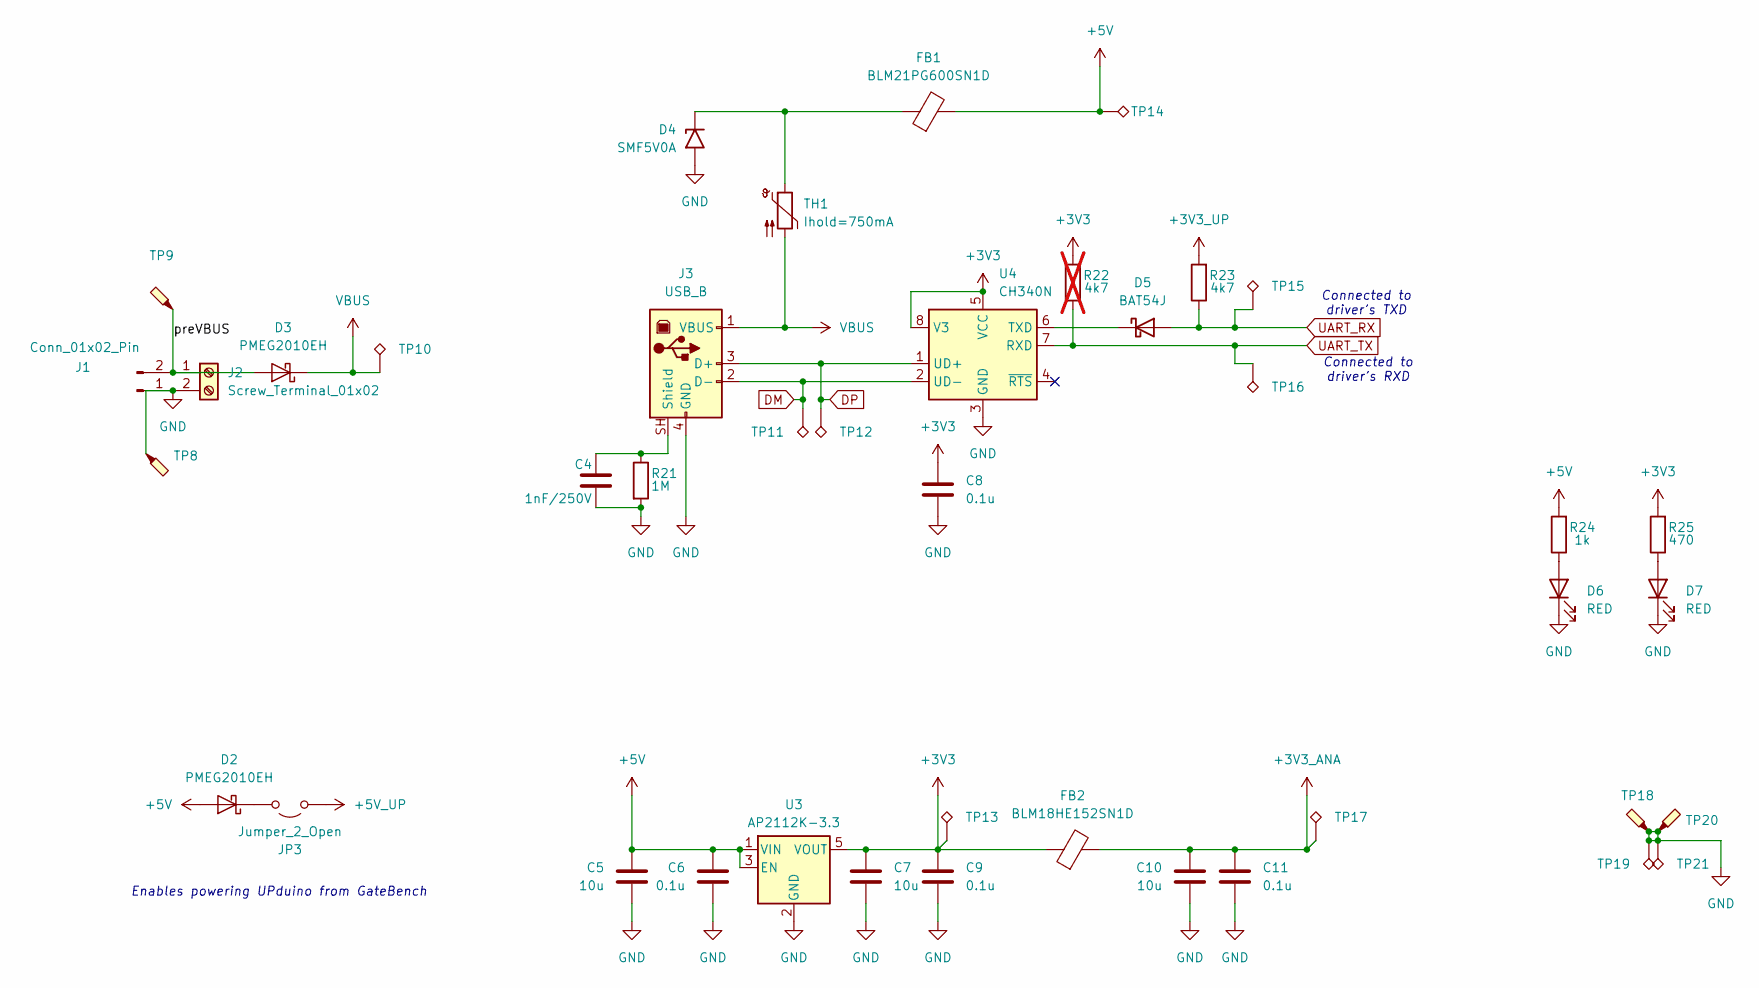
[picture p9: schematic powernusb.kicad_sch]

Parts:
C4: 1nF/250V; C_0603_1608Metric_Pad1.08x0.95mm_HandSolder; JLCPCB C277510
C5, C7, C10: 10u; C_0603_1608Metric_Pad1.08x0.95mm_HandSolder; JLCPCB C1705
C6, C8, C9, C11: 0.1u; C_0603_1608Metric_Pad1.08x0.95mm_HandSolder; JLCPCB C1705
D2: PMEG2010EH; SOT-583-8
D3: PMEG2010EH; Nexperia_CFP3_SOD-123W
D4: SMF5V0A; D_SMF
D5: BAT54J; SOT-323_SC-70
D6, D7: RED; LED_0603_1608Metric; LCSC Part # C2286
FB1: BLM21PG600SN1D; L_0805_2012Metric; LCSC Part # C18305
FB2: BLM18HE152SN1D; L_0603_1608Metric; LCSC Part # C82155
J1: Conn_01x02_Pin; Molex_KK-254_AE-6410-02A_1x02_P2.54mm_Vertical
J2: Screw_Terminal_01x02; TerminalBlock_Phoenix_MKDS-1,5-2-5.08_1x02_P5.08mm_Horizont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
J3: USB_B; USB_B_OST_USB-B1HSxx_Horizontal; JLCPCB C456014
JP3: Jumper_2_Open; TestPoint_2Pads_Pitch2.54mm_Drill0.8mm
R21: 1M; R_0603_1608Metric; JLCPCB C22356623
R22: 4k7; R_0603_1608Metric; JLCPCB C22356621; not fitted
R23: 4k7; R_0603_1608Metric; JLCPCB C22356621
R24: 1k; R_0603_1608Metric; JLCPCB C22356621
R25: 470; R_0603_1608Metric; JLCPCB C22356621
TH1: Ihold=750mA; R_1206_3216Metric
TP8, TP9, TP18, TP20: TestPoint_Probe; TestPoint_Loop_D2.60mm_Drill0.9mm_Beaded
TP10, TP11, TP12, TP13, TP14, TP15, TP16, TP17, TP19, TP21: TestPoint_Alt; PinHeader_1x01_P2.54mm_Vertical
U3: AP2112K-3.3; SOT-23-5; JLCPCB C51118
U4: CH340N; JEITA_SOIC-8_3.9x4.9mm_P1.27mm

Connections:
+3V3: C7.1, C8.1, C9.1, FB2.1, R22.2, R25.2, TP13.1 (1_1), U3.5 (VOUT), U4.5 (VCC), U4.8 (V3); also elsewhere on the board
+3V3_ANA: C10.1, C11.1, FB2.2, TP17.1 (1_1); also elsewhere on the board
+3V3_UP: R23.2; also elsewhere on the board
+5V: C5.1, C6.1, D2.2 (A), FB1.2, R24.2, TP14.1 (1_1), U3.1 (VIN), U3.3 (EN); also elsewhere on the board
+5V_UP: JP3.2 (B); also elsewhere on the board
/Power & USB/preVBUS: D3.2 (A), J1.2, J2.1, TP9.1 (1_1)
DM: J3.2 (D-), TP11.1 (1_1), U4.2 (UD-)
DP: J3.3 (D+), TP12.1 (1_1), U4.1 (UD+); also elsewhere on the board
GND: C4.1, C5.2, C6.2, C7.2, C8.2, C9.2, C10.2, C11.2, D4.2 (A2), D6.1 (K), D7.1 (K), J1.1, J2.2, J3.4 (GND), R21.2, TP8.1 (1_1), TP18.1 (1_1), TP19.1 (1_1), TP20.1 (1_1), TP21.1 (1_1), U3.2 (GND), U4.3 (GND); also elsewhere on the board
unnamed: D2.1 (K), JP3.1 (A)
unnamed: D4.1 (A1), FB1.1, TH1.1
unnamed: D5.1 (K), U4.6 (TXD)
unnamed: D6.2 (A), R24.1
unnamed: D7.2 (A), R25.1
unnamed: C4.2, J3.SH (Shield), R21.1
UART_RX: D5.2 (A), R23.1, TP15.1 (1_1); also elsewhere on the board
UART_TX: R22.1, TP16.1 (1_1), U4.7 (RXD); also elsewhere on the board
VBUS: D3.1 (K), J3.1 (VBUS), TH1.2, TP10.1 (1_1)

Notes on the sheet:
Connected to driver's RXD
Enables powering UPduino from GateBench
Connected to driver's TXD

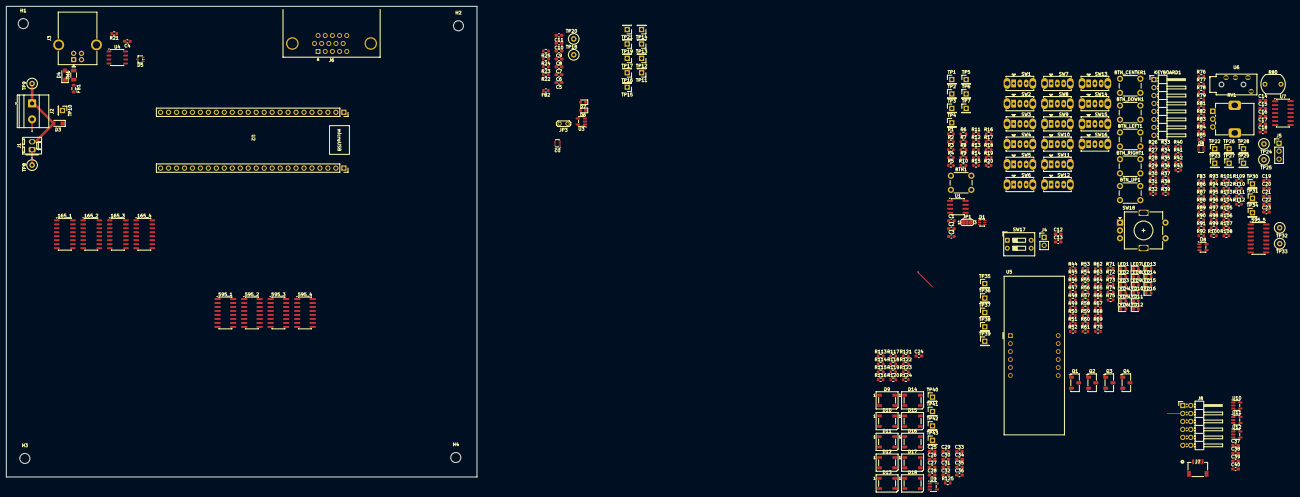
[picture p10: board gatebench.kicad_pcb from above]

Board: 4 copper layers, 150.0 x 150.0 mm, 311 parts (0 on the bottom side), 227 nets.
