alheir/gatebench/(commit log)

2026-08-29 tracking KiCad 3D files with Git LFS
2026-08-29 feat: add initial board definition document for GateBench
2026-08-31 chore: allow docs CSVs and ignore KiCad lock files
    The KiCad gitignore template blocked all CSVs, which would have dropped docs/pinout.csv.
2026-08-31 chore(hw): add KiCad project and vendor libraries
    Vendored UPduino, PJ-320A and JST SM04B libs so the schematic is self-contained.
2026-08-31 chore(hw): add 3D STEP models
    Custom models for UPduino, USB-B, EC11 and the rotary pot, stored in Git LFS.
    [EC11_Rotary_Encoder_Switched.step, R-0904N-L-20KQ.step, UPduino_v3.01.step, USB_B_OST_USB-B1HSxx_Horizontal.step]
2026-08-31 feat(hw): scaffold hierarchical schematic and PCB
    WIP schematic with power, scan chains, ADC, DAC, VGA and WS2812 sheets, plus initial footprint placement.
    [adc.kicad_sch, dac.kicad_sch, gatebench.kicad_pcb, gatebench.kicad_sch, inputchain.kicad_sch, outputchain.kicad_sch, powernusb.kicad_sch, vga.kicad_sch]
2026-09-05 feat(hw): closing sch, starting pcb
    [adc.kicad_sch, dac.kicad_sch, expansion.kicad_sch, gatebench.kicad_pcb, gatebench.kicad_sch, inputchain.kicad_sch, outputchain.kicad_sch, powernusb.kicad_sch]
